itzYAGAMI/The-Aegis-T17-Chronicle-Handheld-Console-/3d_image_pcb.png

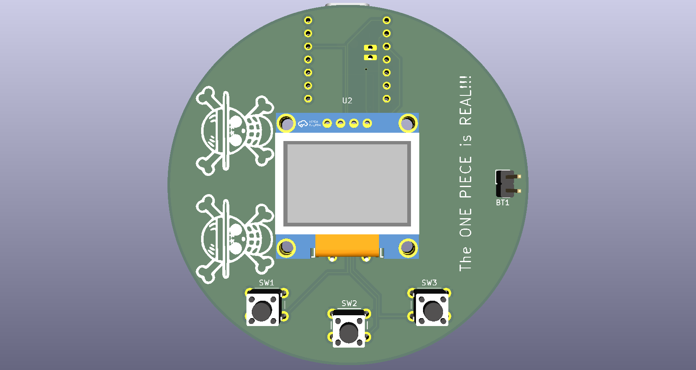
3d_image_pcb.png
