itzYAGAMI/The-Aegis-T17-Chronicle-Handheld-Console-/BOM.csv

S. No. | Name of Component | Quantity | Price(Rs.) | Link
1 | Seeed Studio XIAO ESP32C3 | 1 | 734 | https://robocraze.com/products/seeed-studio-xiao-esp32c3?variant=46039428366560&country=IN&currency=INR
2 | 0.96" OLED Screen | 1 | 144 | https://quartzcomponents.com/products/oled-display-0-96-inch-i2c-interface-4-pin-blue-ssd1306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
3 | Tactile Push Button | 3 | 19 | https://robu.in/product/6x6x5-tactile-push-button-switch/
4 | 5V Passive Buzzer | 1 | 49 | https://robu.in/product/1-month-warranty-1248/
5 | 3.7 V 503040 Battery | 1 | 347 | https://www.amazon.in/KP-Original-503040-Rechargeable-Battery-Bluetooth/dp/B0D517DPBJ
6 | 20mm Mini Button Compass | 1 | 249 | https://www.amazon.in/gp/product/B0BW96BKNC?smid=A228ZPPAD6KMBB&psc=1
7 | Spray Paint | 1 | 209 | https://www.amazon.in/gp/product/B08F7KLWKH?smid=AJ6SIZC8YQDZX&psc=1
8 | Filler Primer | 1 | 190 | https://www.amazon.in/APAR-Surfacer-Plastics-Furnitures-industrial/dp/B0CTKZ1K93?sr=8-9
9 | Tension Spring | 1 | 198 | https://www.amazon.in/IMPRINT-Extension-Assortment-Different-Projects/dp/B0H95K8DRP?sr=8-7
10 | M2 Screws | 4 | 3.6 | https://onlyscrews.in/products/m2-x-5mm-phillips-round-head-laptop-screw
 |  | Total: | 2190.9
 |  |  | (Without Shipping)
