itzYAGAMI/The-Aegis-T17-Chronicle-Handheld-Console-/CAD Files/steampunk_tamagotchi.step

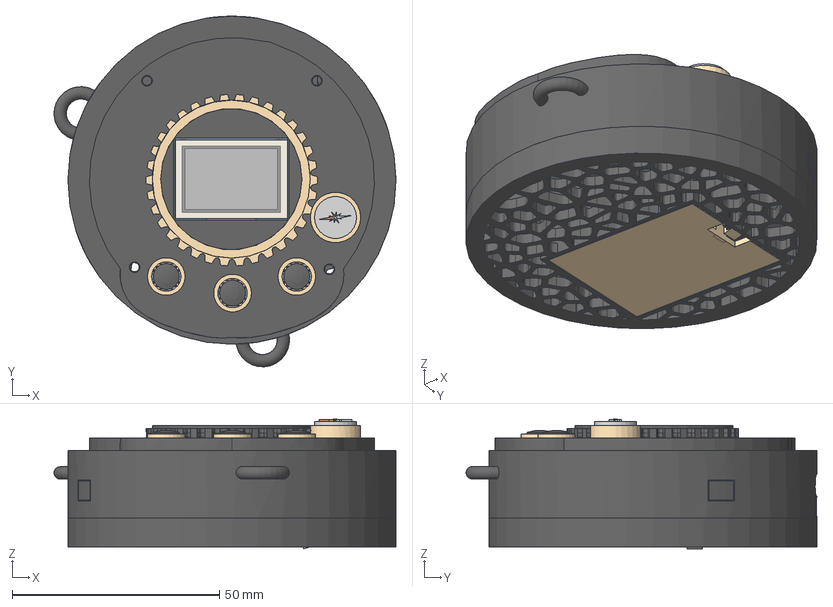
[picture p4: CAD file, 2026-10-25]
CAD Files/steampunk_tamagotchi.step
82.6 x 84.7 x 31.3 mm
