itzYAGAMI/The-Aegis-T17-Chronicle-Handheld-Console-/(list of files, cad)

Other CAD files:
CAD Files/Aegis T17 Chronicle.f3z
CAD Files/steampunk_tamagotchi.3mf
CAD Files/steampunk_tamagotchi.stl
