itzYAGAMI/The-Aegis-T17-Chronicle-Handheld-Console-/PCB Files/Tamagotchi.kicad_pcb

## KiCad design PCB Files/Tamagotchi.kicad_pcb (2026-10-25)

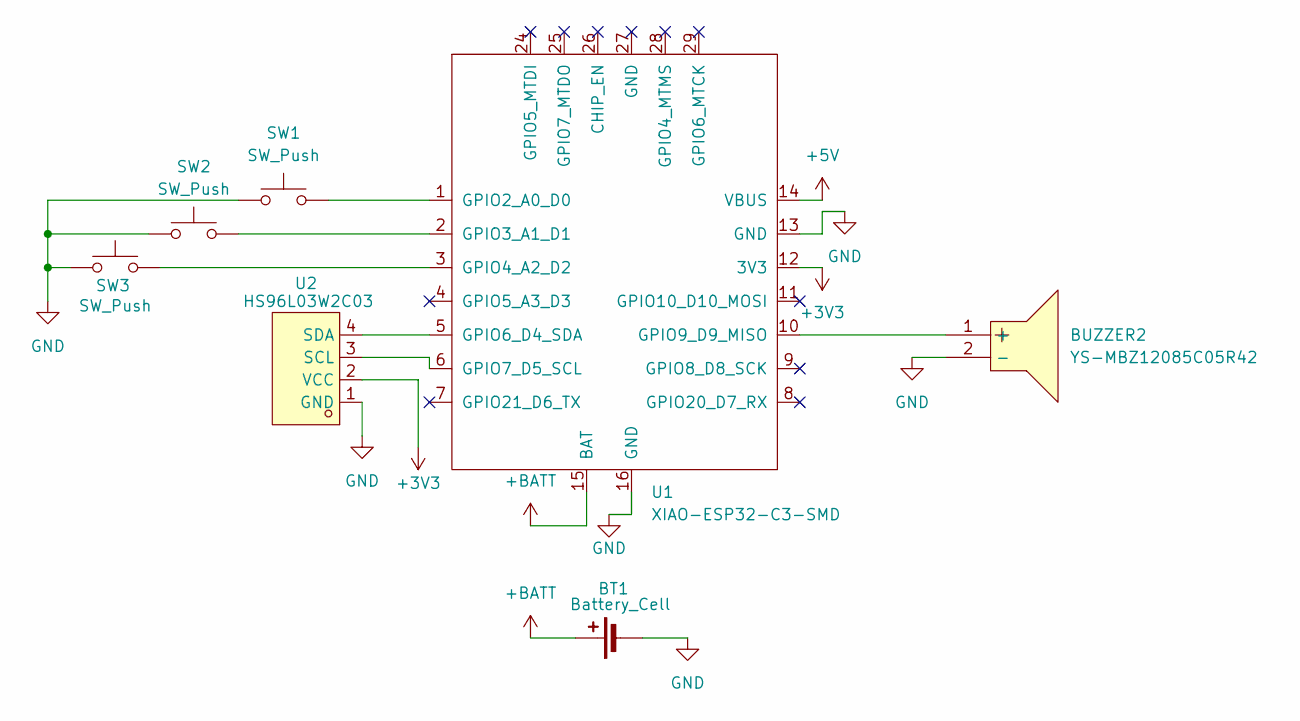
[picture p5: schematic Tamagotchi.kicad_sch]

Parts:
BT1: Battery_Cell; PinHeader_1x02_P2.54mm_Vertical
BUZZER2: YS-MBZ12085C05R42; BUZ-TH_BD12.0-P6.50-D0.6-FD; MPN YS-MBZ12085C05R42; LCSC Part C409842
SW1, SW2, SW3: SW_Push; SW_PUSH_6mm_H5mm
U1: XIAO-ESP32-C3-SMD; XIAO-ESP32-C3-DIP-SMD
U2: HS96L03W2C03; OLED-TH_L27.8-W27.2-P2.54_C9900033791; MPN HS96L03W2C03; LCSC Part C5248080

Connections:
+3V3: U1.12 (3V3), U2.2 (VCC)
+5V: U1.14 (VBUS)
+BATT: BT1.1 (+), U1.15 (BAT)
GND: BT1.2 (-), BUZZER2.2 (-), SW1.1, SW2.1, SW3.1, U1.13 (GND), U1.16 (GND), U2.1 (GND)
unnamed: BUZZER2.1 (+), U1.10 (GPIO9_D9_MISO)
unnamed: SW1.2, U1.1 (GPIO2_A0_D0)
unnamed: SW2.2, U1.2 (GPIO3_A1_D1)
unnamed: SW3.2, U1.3 (GPIO4_A2_D2)
unnamed: U1.5 (GPIO6_D4_SDA), U2.4 (SDA)
unnamed: U1.6 (GPIO7_D5_SCL), U2.3 (SCL)

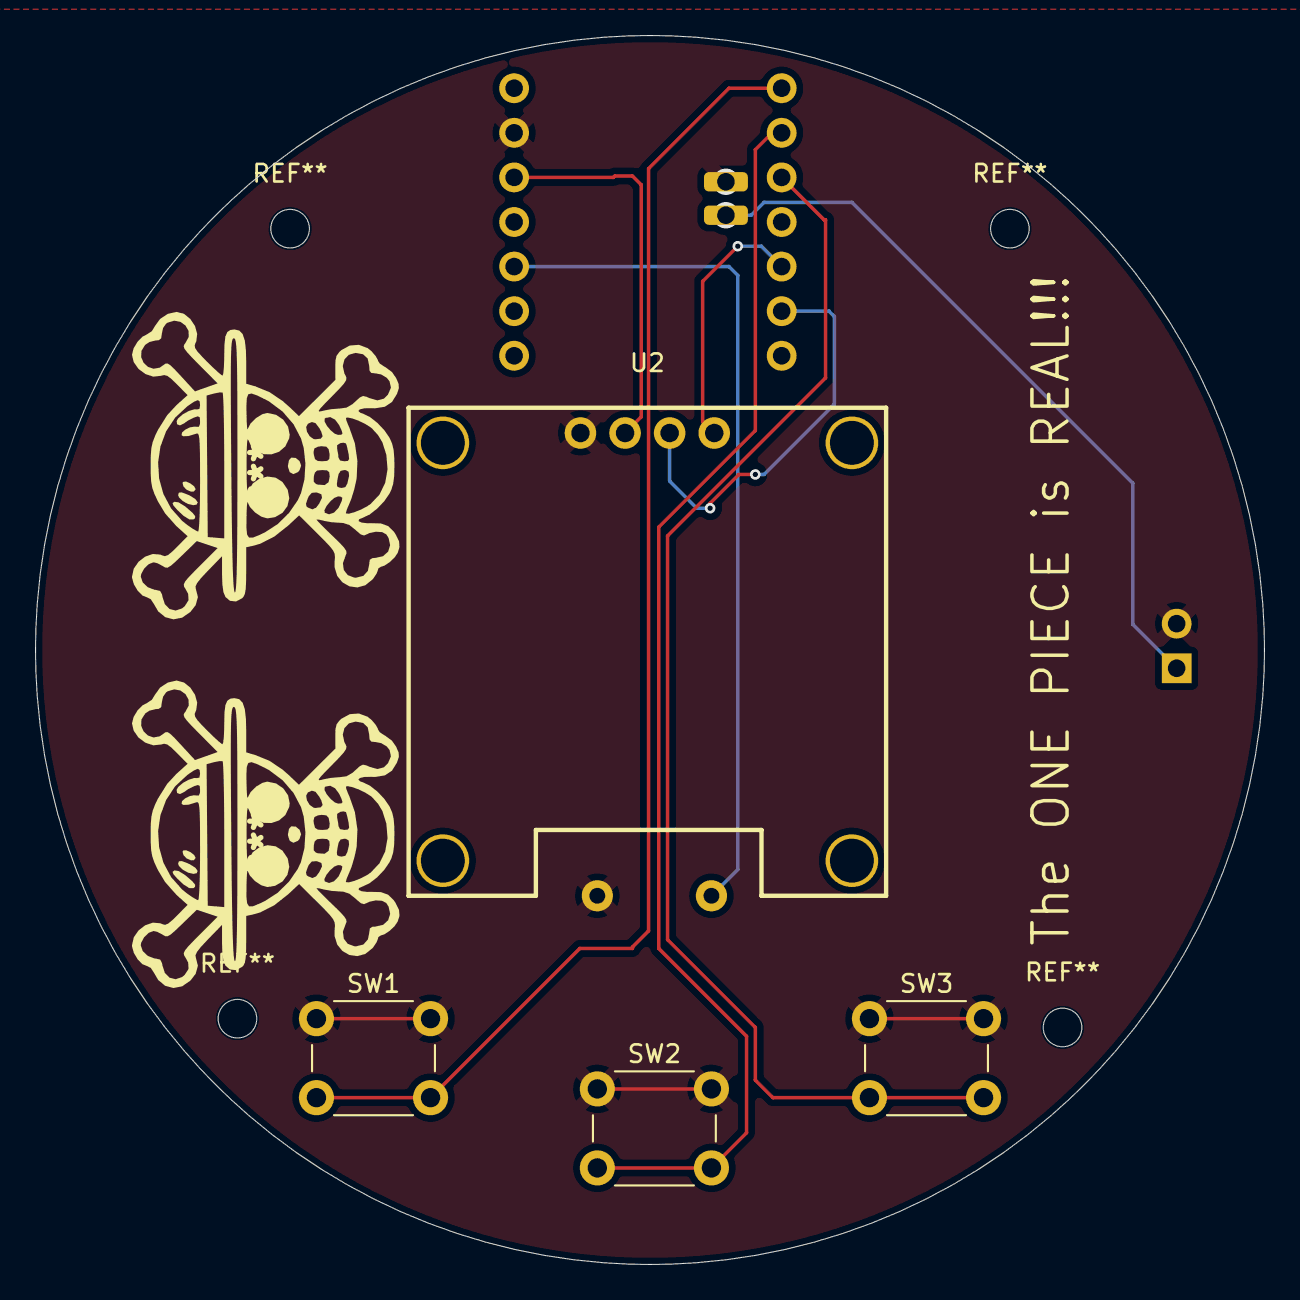
[picture p6: board Tamagotchi.kicad_pcb from above]

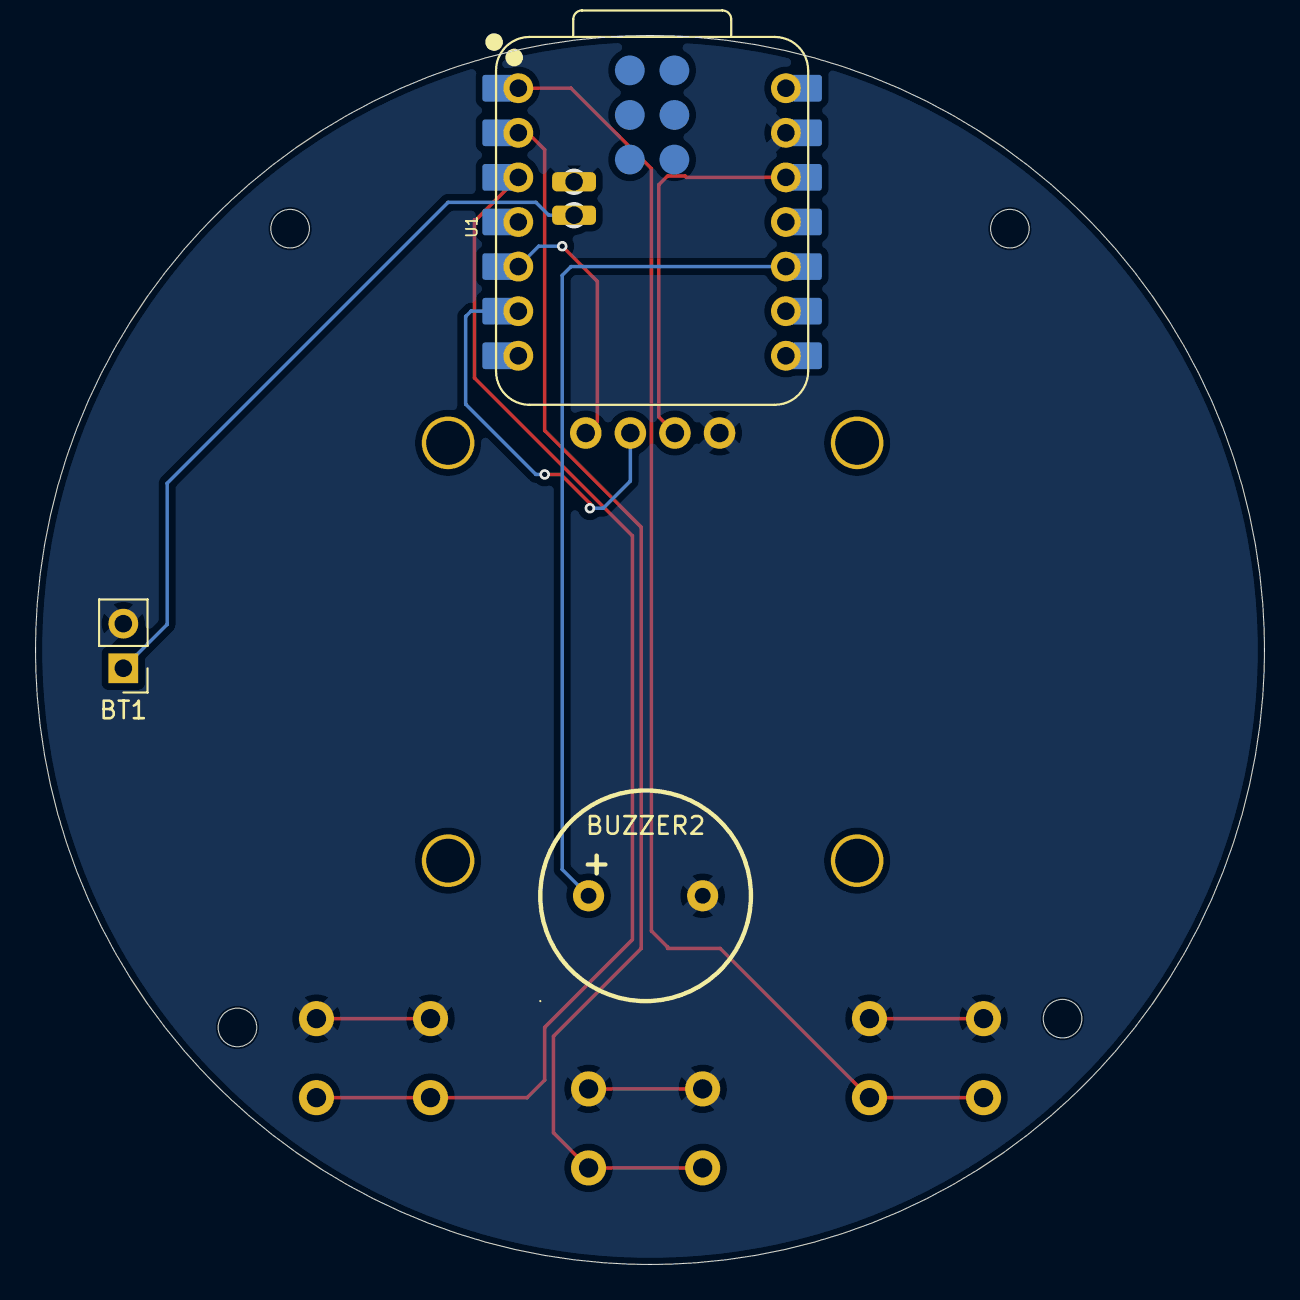
[picture p7: board Tamagotchi.kicad_pcb from below]

Board: 2 copper layers, 70.0 x 70.0 mm, 7 parts (3 on the bottom side), 9 nets.
